Liren66/OminiCore-SDR-Hardware/3D Model/CNC/CNC_Lower.step

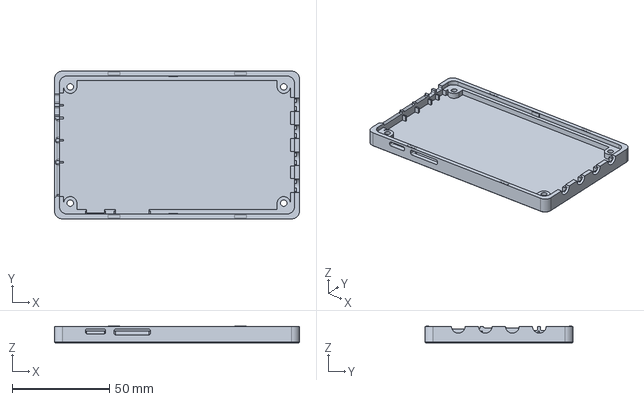
[picture p5: CAD file, 2026-10-30]
3D Model/CNC/CNC_Lower.step
126.0 x 76.0 x 8.55 mm
