Liren66/OminiCore-SDR-Hardware/3D Model/FDM/FDM_Lower.step

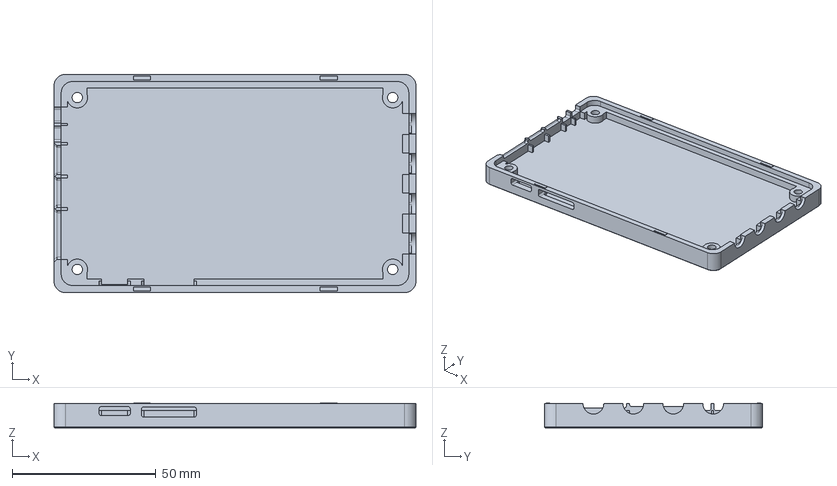
[picture p6: CAD file, 2026-10-30]
3D Model/FDM/FDM_Lower.step
126.0 x 76.0 x 8.70 mm
