Liren66/OminiCore-SDR-Hardware/3D Model/CNC/CNC_Upper.step

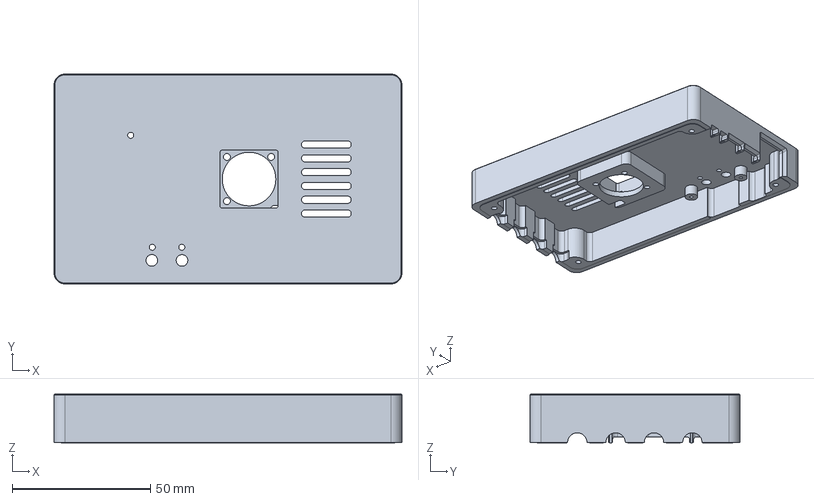
[picture p7: CAD file, 2026-10-30]
3D Model/CNC/CNC_Upper.step
126.0 x 76.0 x 17.7 mm
