Liren66/OminiCore-SDR-Hardware/3D Model/FDM/FDM_Button_Carrier.step

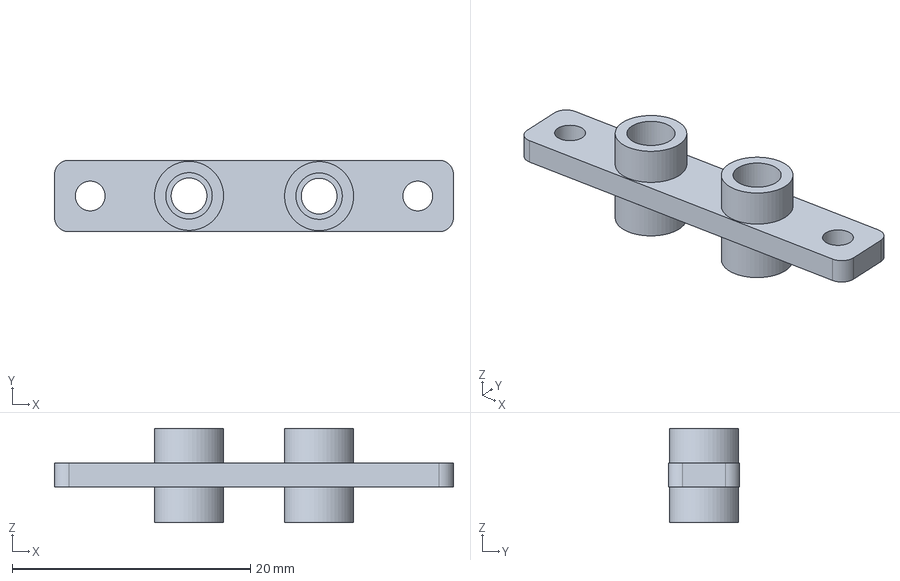
[picture p8: CAD file, 2026-10-30]
3D Model/FDM/FDM_Button_Carrier.step
33.5 x 6.00 x 7.90 mm
