Liren66/OminiCore-SDR-Hardware/3D Model/CNC/CNC_Upper_Laser_Drawing.dxf

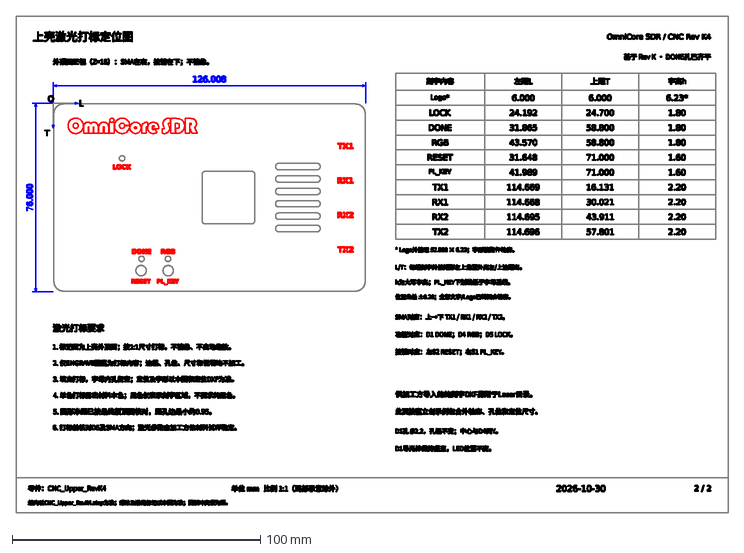
[picture p9: CAD file, 2026-10-30]
3D Model/CNC/CNC_Upper_Laser_Drawing.dxf
287.0 x 200.0 mm
