Liren66/OminiCore-SDR-Hardware/3D Model/FDM/FDM_Button.step

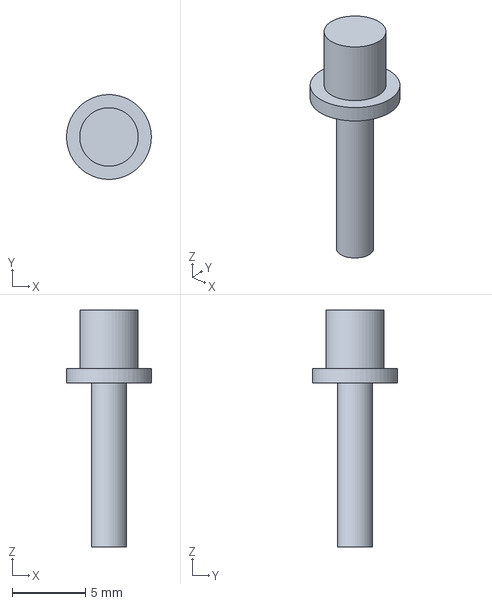
[picture p10: CAD file, 2026-10-30]
3D Model/FDM/FDM_Button.step
5.79 x 5.80 x 16.2 mm
