Liren66/OminiCore-SDR-Hardware/3D Model/CNC/02_ENGRAVE_ONLY_mm.dxf

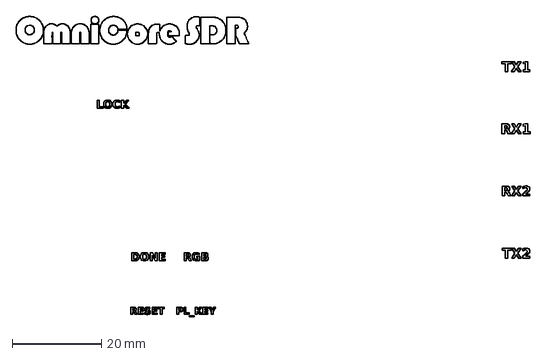
[picture p11: CAD file, 2026-10-30]
3D Model/CNC/02_ENGRAVE_ONLY_mm.dxf
114.9 x 67.1 mm
