Liren66/OminiCore-SDR-Hardware/(list of files, cad)

Other CAD files:
3D Model/FDM/FDM_Upper.step
3D Model/CNC/CNC_Button_Carrier.step
3D Model/CNC/CNC_Button.step
3D Model/CNC/CNC_Button.stl
3D Model/CNC/CNC_Button_Carrier.stl
3D Model/CNC/CNC_Lower.stl
3D Model/CNC/CNC_Upper.stl
3D Model/FDM/FDM_Button.stl
3D Model/FDM/FDM_Button_Carrier.stl
3D Model/FDM/FDM_Lower.stl
3D Model/FDM/FDM_Upper.stl
