Liren66/OminiCore-SDR-Hardware/3D Model/CNC/CNC_Upper.pdf

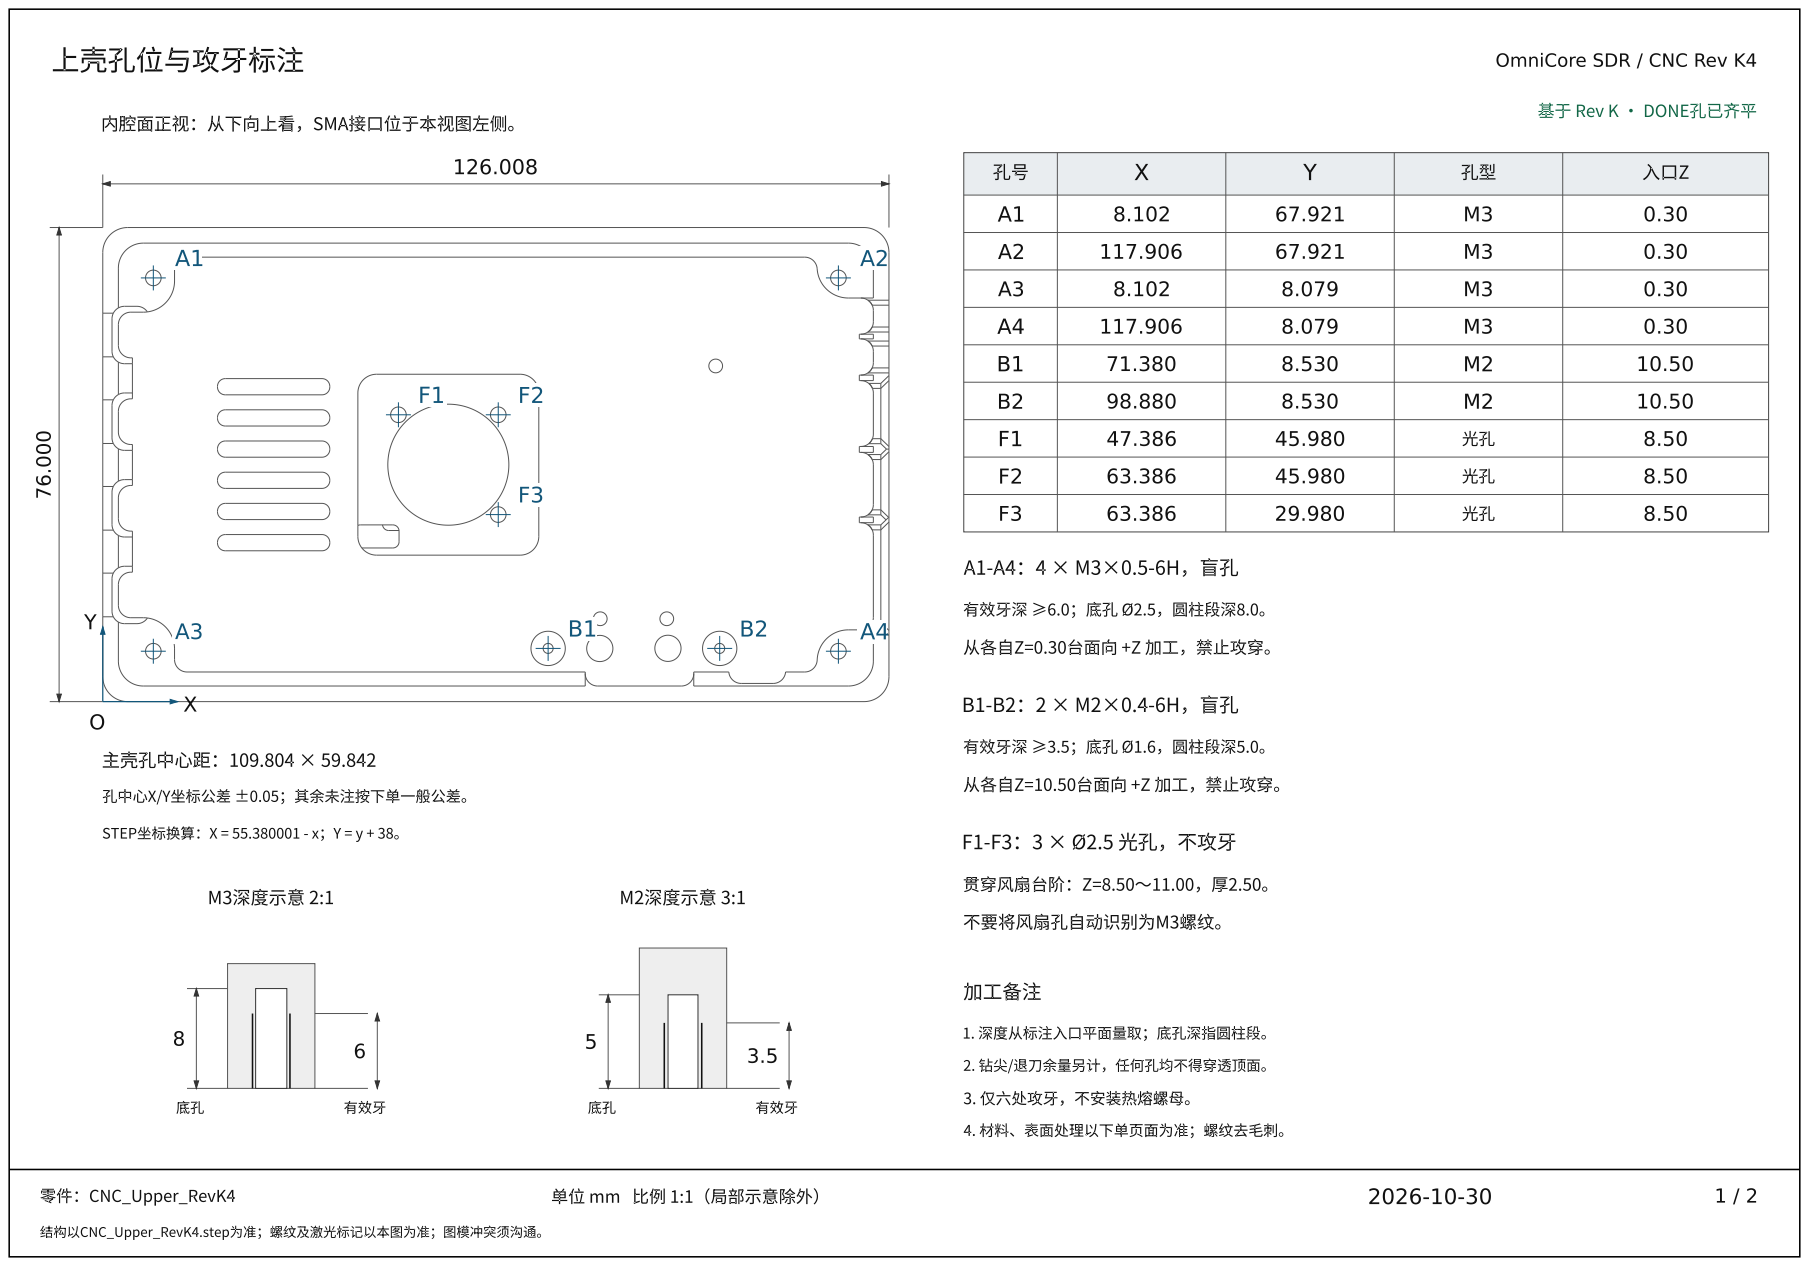
[picture p12: page 1]

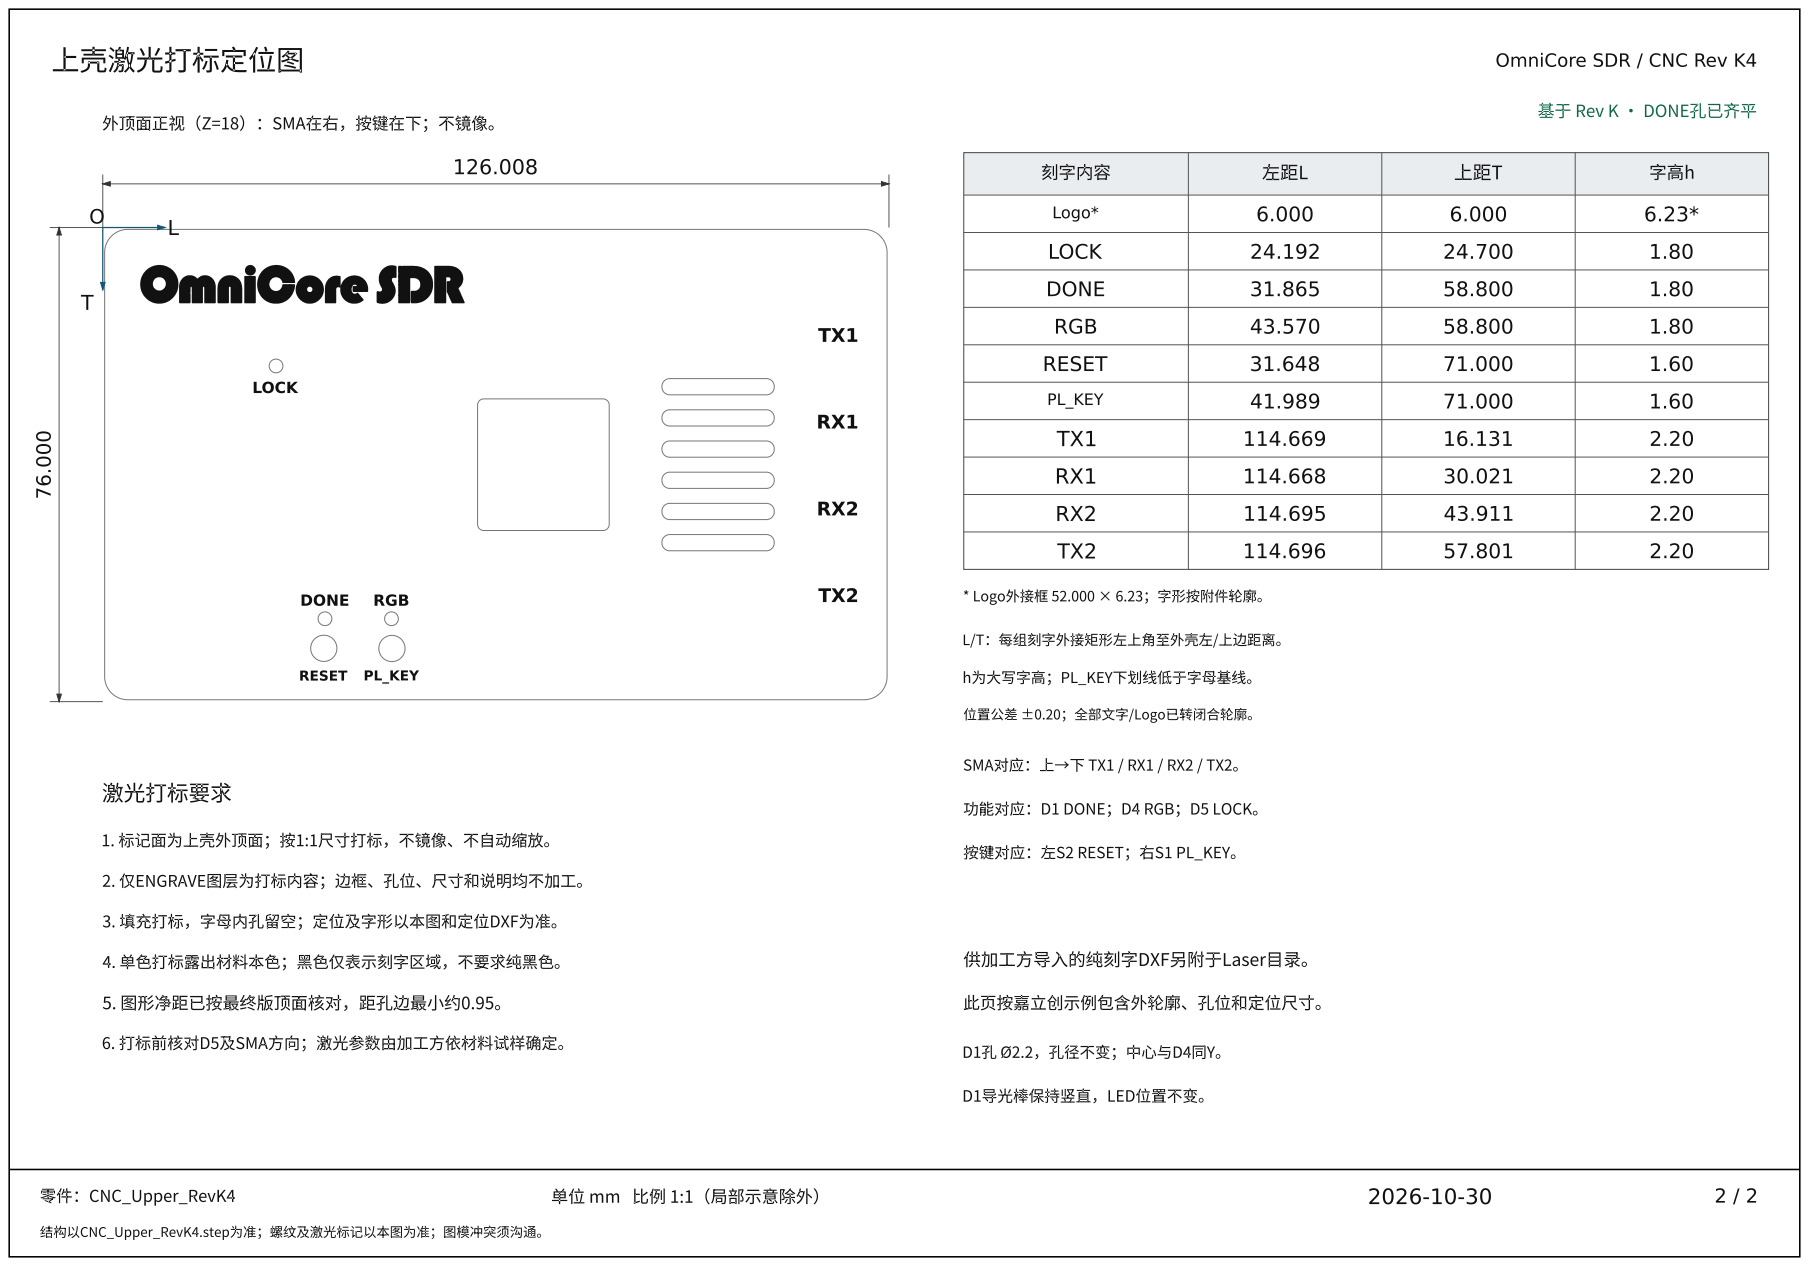
[picture p13: page 2]
