Liren66/OminiCore-SDR-Hardware/(list of files, drawings)

Other design files:
AD9361.SchDoc
AD9361_RF.SchDoc
CH32H417_USB3.SchDoc
Clock.SchDoc
DDR3.SchDoc
JTAG.SchDoc
LAN_SD.SchDoc
OminiCore_SDR.PrjPcb
OmniCore_SDR.PcbDoc
OmniCore_SDR.PrjPcb
PL_IO.SchDoc
PS_IO.SchDoc
Sys_Power.SchDoc
ZYNQ_Power.SchDoc
