Liren66/OminiCore-SDR-Hardware/(commit log)

2026-10-24 修复了PPS控制问题
    [CH32H417_USB3.SchDoc, Clock.SchDoc, OminiCore_SDR.PcbDoc, OminiCore_SDR.PrjPcb]
2026-10-25 工程更名为 OmniCore_SDR，统一 Omni 拼写
    - OminiCore_SDR.PrjPcb/PcbDoc/IntLib 重命名为 OmniCore_SDR.*
    - README 标题改为 OmniCore-SDR-Hardware
    - .gitignore 改用通配规则忽略 Altium 输出、日志和 PrjPcbStructure
    [OmniCore_SDR.PcbDoc, OmniCore_SDR.PrjPcb]
2026-10-29 新增3D模型
    [CNC_Button_Carrier.stl, CNC_Button_S1.stl, CNC_Button_S2.stl, CNC_Lower.stl, CNC_Upper.stl, FDM_Button.stl, FDM_Button_Carrier.stl, FDM_Lower.stl]
2026-10-30 修改3D外壳
    [02_ENGRAVE_ONLY_mm.dxf, CNC_Button.step, CNC_Button.stl, CNC_Button_Carrier.step, CNC_Button_Carrier.stl, CNC_Button_S1.stl, CNC_Button_S2.stl, CNC_Lower.step]
2026-10-30 更新readme
